hasithperera/Tensegrity-casuals-docs/README.md

# Tensegrity-casuals-docs

Documentation for the Clemson Tensegrity challenge team **Casuals**

## How to setup

1. Install [Obsidian-md](https://obsidian.md/) or any other editor program you prefer
	- obsidian is cross platform and is the preferred way to contribute to these docs
2. Clone the git repository: `git clone git@github.com:hasithperera/Tensegrity-casuals-docs.git`
3. To get write access to the repo contact the admin and you need to add an ssh key to your account - I can help with these (please ask next meeting)
4. Modify and commit your changes as needed
	- Be as descriptive as possible to make others understand the impact

## Basics

- Keep all binary files inside `res`
- Use basic Markdown and LaTeX syntax as needed
- Open the `source control view` for easy git actions

## To-do task list (auto-populated)

```tasks
# Only tasks that are not done, that is, which begin like this (but without the quotes):
#   '- [ ] ' or
#   '* [ ] ' or
#   '1. [ ] '
# Indented tasks are supported, but only single-line tasks.
not done
````
