hasithperera/Tensegrity-casuals-docs/models/Readme.md

# Strut model with ratchet

Designed by Justin H.

- Ratchet knob print settings:
	- Filament: PLA
	- Layer Height: 0.15 mm STRUCTURAL
	- Infill: 100%
	- Supports (Optional) : Everywhere - Organic
	- Print on flat face of turning knob side

- Strut body print settings:
	- Filament: PLA
	- Layer Height: 0.20 mm STRUCTURAL
	- Infill: 25%
	- Supports (Optional) : Everywhere - Organic 
	- Brim (Optional): 5 mm
	- Print upright on flat face of one end

## Current design outputs

## Ratchet

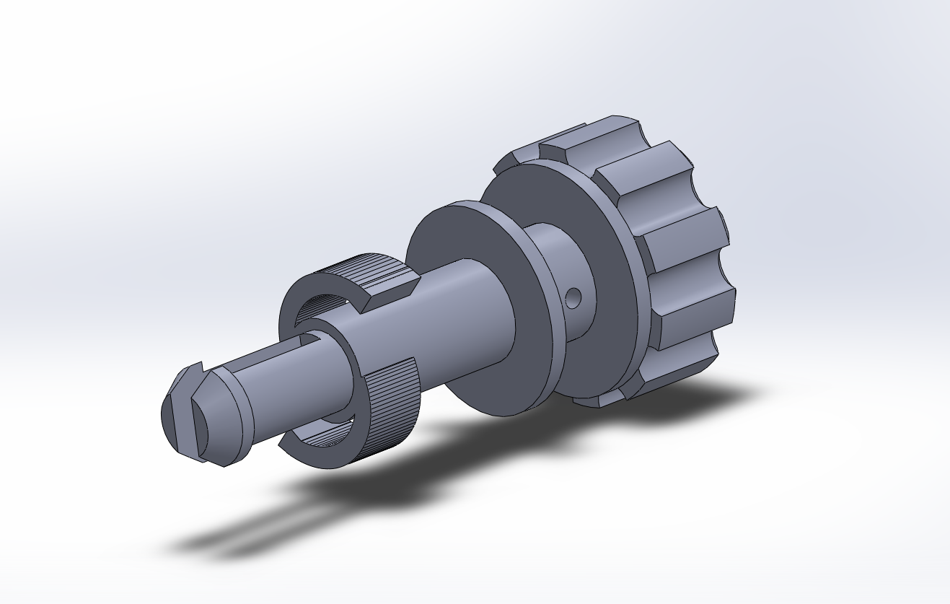
[picture p1: models/res/Ratchet Knob CAD.png]


## Strut body

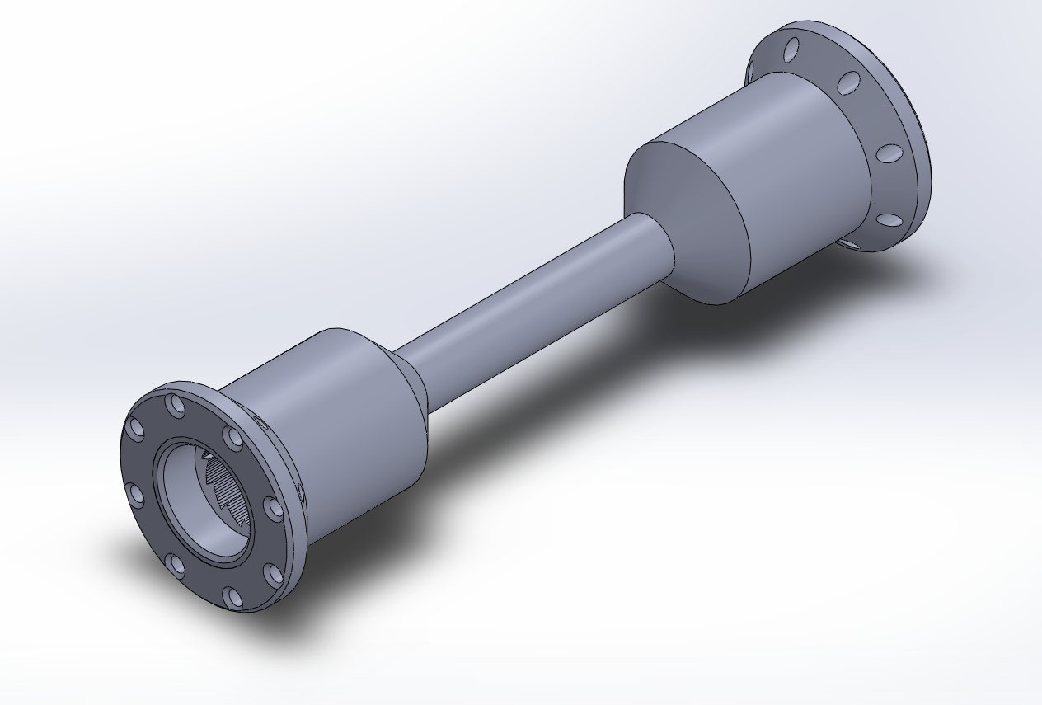
[picture p2: models/res/Strut Body CAD.png]


---
## v2 - Changes

- Some design changes that Hasith proposed to fix some of the containment issues in the current design
	- Add a locking plate to hold everything in place in the unlocked state
	- change the end to make it less flexible
	- add a locking plate to the knob, add a disk to the end, make it disengage the rotation while holding the axis

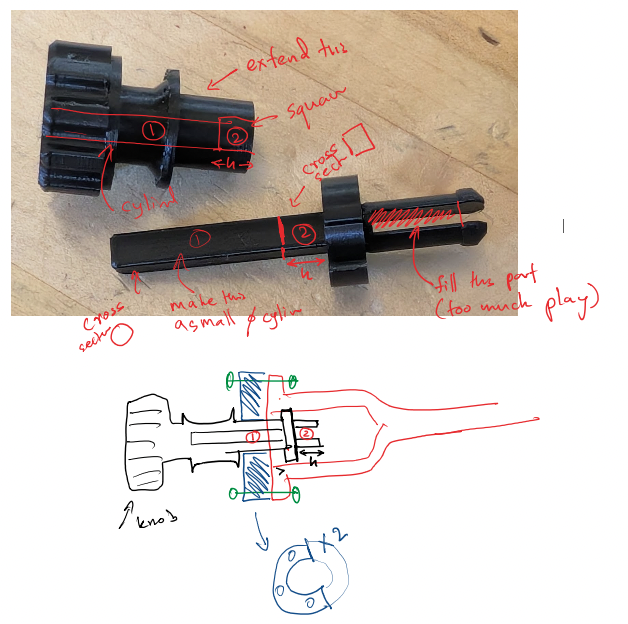
[picture p3: models/res/Pasted image 20261026123235.png]
