hasithperera/Tensegrity-casuals-docs/docs/Mechanical design and notes.md

---
marp: "true"
paginate: "True"
footer: "**Tensegrity** **Clemson University**  **Casuals**"
theme: neobeam-neonbeam
---

##  Status - 12 Nov

- David and I tested the fits; the cheaper motor I substituted with has a different clearance for the 6-pin connector (probably why it was cheap, oh well ) 
    - We did some destructive mods for the motor holder and it can be modified to fit the current motors we have. (it should probably be fine)
    - Refer to pictures below for needed modifications

## Other thoughts
- Please throw all the unwanted old case/PCB holders
	- do we actually have usable parts printed
- Figure out PCB mounting and take notes

---
## Modifications needed - David FYI

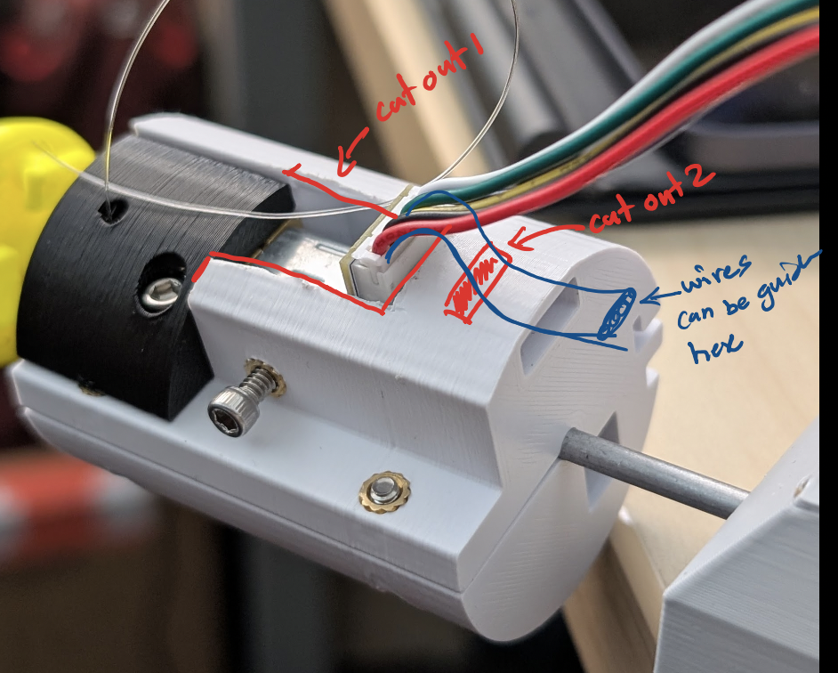
[picture p9: docs/res/Pasted image 20261112125232.png]
center


---
## Modification
- David's design was off, dimensions were not correct. Hasith redid it for quick verification
- Need to print and test for clearance, Design shown below

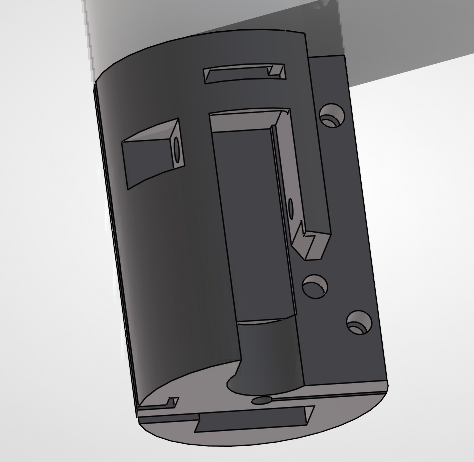
[picture p10: docs/res/Pasted image 20261113000306.png]


---

## Todo
- [ ] Redesign Motor holder #David 
	- [ ] Print PLA test design by 📅 2026-11-13  #Hasith 
- [ ] Figure out the PCB mounting
- [ ] end cap has issues; either redesign or use glue etc
