hasithperera/Tensegrity-casuals-docs/docs/PCB Design.md

# Yale design files

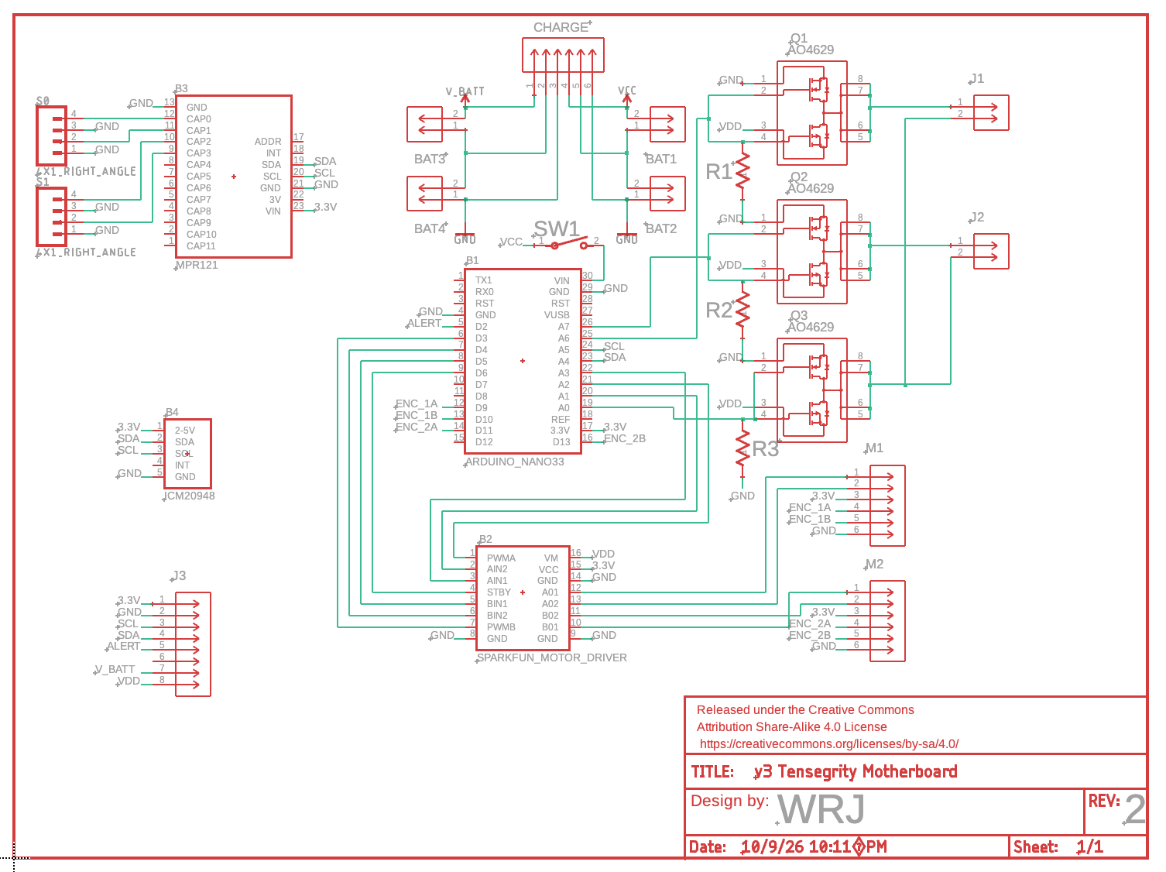
[picture p11: docs/res/Pasted image 20261009222900.png]


---
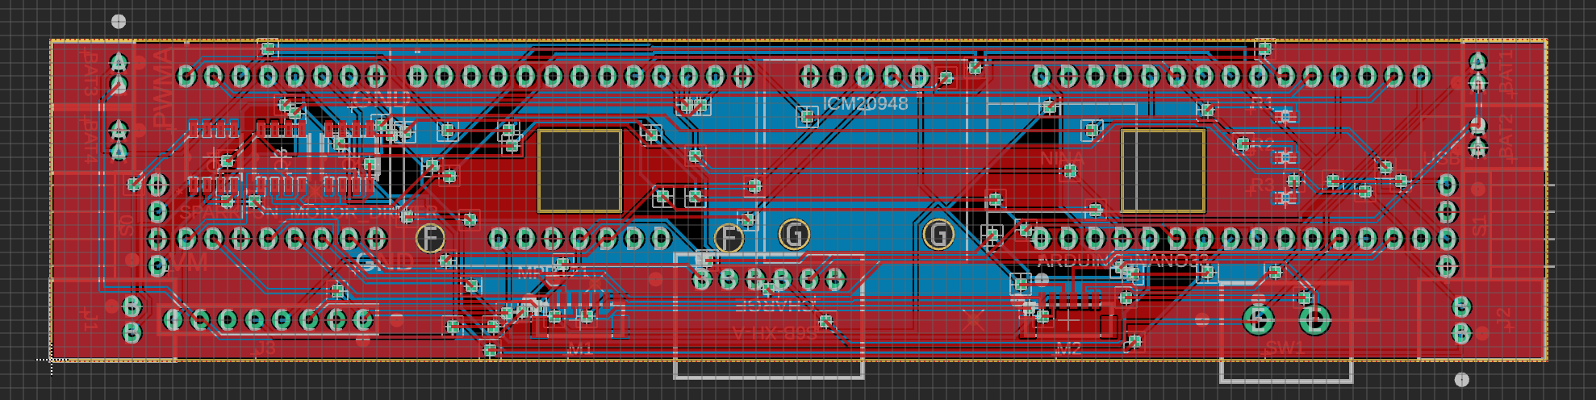
[picture p12: docs/res/Pasted image 20261009223906.png]


---
# Notes:
- There are 4 single cells: Bat 1 - 4, and these are connected to 2 x 2S cells
- Q1-3 :  AO4620
	- Dual MOSFETs, but what are these for? They are not for charging 
	- J1 J2: these are labeled as electromagnets. drive high current but what for ?
		- I don't think this is needed for this project
- Paper: https://ieeexplore.ieee.org/abstract/document/11474858
- VDD and V_Bat are connected through the [current sense module](https://mm.digikey.com/Volume0/opasdata/d220001/medias/docus/8891/4226-Datasheet.pdf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)
	- This is why they are shorted if no module is used

---
## BOM per node:
- Nano 33 IOT
- Motor driver
- Current sensor
- Connectors
---
