hasithperera/Tensegrity-casuals-docs/docs/Team logistics - Project management.md

## Task list and timeline

- [x] Document the model - pull some dimensions #David 📅 2026-10-16 ✅ 2026-10-15
	- 50-70% 
- [x] Make a scale-down mock model 📅 #Justin ⏳ 2026-10-16 ✅ 2026-10-15
- [x] Look into the PCB - remake it #Hasith 📅 2026-10-16 ✅ 2026-10-19
	- [x] Completed the PCB review ✅ 2026-10-09
	- [x] KiCad redesign 📅 2026-10-12 ✅ 2026-10-16
- [x] BOM - translation to our case (ASAP) ✅ 2026-10-19
	- Mechanical #David #Jaylin
	- Electronics #Hasith 
- [x] Schedule a meeting with Lu: #Hasith ✅ 2026-10-15
	- [x] Thursday afternoon - email her about a meeting ✅ 2026-10-19
	- [x] Talk about the high-level plan ✅ 2026-10-09
	- [x] Controller design - external controller ✅ 2026-10-09
---
# PCB dimensions from Yale

bg right contain

- This is the Yale control board; the COTS board has everything you need and more, but the physical dimensions are not feasible
- We are leaning toward a custom PCB order with a minimum design
	- Remove force feedback, but maintain the form factor
	- Add the current module 
---
# Sensor and data availability: single node 

- Each node will have
	- 9 DOF from the IMU
	- 2 Motor rotation counts 
	- 2 Current sensor data
- Inputs
	- Motor rotation with counts 
- Data via MQTT - basically the same as a ROS msg without the complications of ROS
---
# Program design 

- Each node will run the same basic firmware - sensor interface and motor drive
	- Send data via MQTT
	- High-speed sensor out via wifi (on request)
- Run the control algorithms on a Raspi/Laptop on the same network
- ROS is a possibility
	- I have done some basics about 10 years ago - on a Raspi
	- This feels like a complication at this stage since I am the only one who does software
---
# Questions

- Can we do an external controller? It's not a self-supported robot - **IS THIS OK ?**
	- I think this would be more fun for me to do
- What is the timeline for funding and fabrication?  - **Custom PCB's take time**
- I am concerned about the force feedback not being there 
	- Counts can only give you perceived inputs and not actually what's going on in the real system
	- This can go very wrong just because of the DOF on the system
- What's the use of the IMU?
	- obviously orientation, but that's kind of complicated
	- I think Yale folks had a forward model and a state estimator running in the background to predict the moves
- Electromagnet?
---
## SMILE design

- Probably more feasible 
- Paper from her website: https://smile-robotics-lab.github.io/assets/documents/papers/Tensegrity-Blocks.pdf
- Carbon rods ?
	- Looks like they are bending when the forces are applied
- Do you know the cost for this
	- 8 corners, X 2 motors each 
		- 16 motors, only 12 edges - so some motors are not needed
		- encorders? yes
		- Force feedback? probably no
---



---

# Meeting with Luyang

- Force feedback is not needed, apparently; it never worked, it seems
- External controller is fine if we do Yale
- Yale design: I think it's the fun way to do it (controller-wise)
- She showed the central controller design 
	- This has carbon fiber and springs already to take that fall as opposed to Yale will have to do it on the run time
	- From a comp point of view: central + bar design is the way to meet their criteria 
		- Yale is easy for all of us: no redesign, we just follow the things they have done and just redo it, nothing new
---

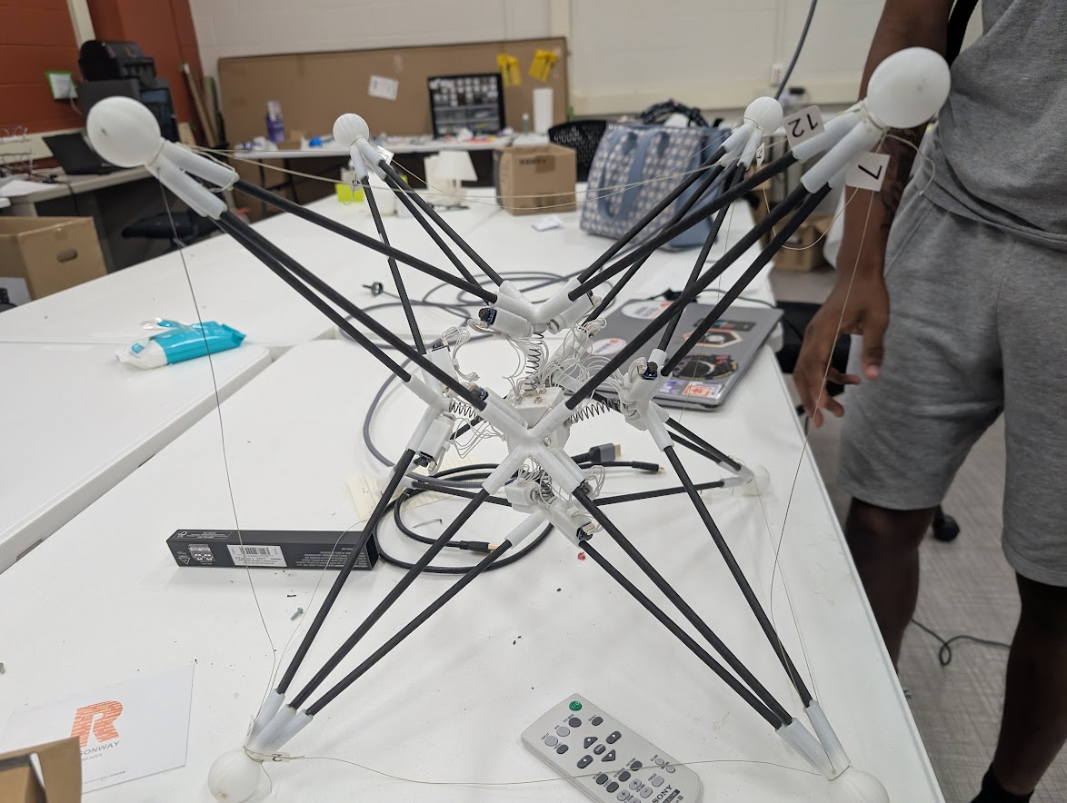
[picture p21: docs/res/Pasted image 20261015161732.png]


---

## Hasith's proposal 

- We do both; ask for more money for the 12-motor design 
	- Needs a design + BOM
	- We try Yale; if it fails, then we still have the components to do the other design
		- Mechanical design needs to be done 
		- Electronics need to be figured out to control 12 motors (this is also probably not easy to fit in that structure)
	- https://www.youtube.com/watch?v=YznAy63wcdw : Possible control system and gate
		- there are apparently a lot of implementations out there
---
## BOM and Proposal here

---
# Agenda - Team meeting 3

## Meeting time Friday 6 - 8 PM

- Talked about the new rule update and what we thing about it as a group
- Agreed to continue the project 
	- explained the replacement and corners we can cut if the budget is important to us
	- Current BOM is the reduced BOM
---
-  Mostly sharing what we learn from tomorrow's meeting, and if they question the cost or whatever, that would go in there
- [ ] Get you all setup with Obsidian and git (get you used to that) #Hasith 
- Programming basics
- Because we have 3 struts, we can write code for it simultaneously. (I am sure I can get it done by myself but getting you guys some skills may help in case I get busy) 
	- [ ] Try to write code with AI ? (I don't like this or do this but you all can try it and see which version does better) 
---
# todo - Mechanical 
- [ ] Justin: tell us how's the progress on the 3D printing #Justin 
	- [x] Model with ratchet: can you send me the files (or put them in git, with a README) ✅ 2026-10-26
	- [ ] Endcap: can we redesign this to print with the resin printer (for some deformable rubber-like material)
- [ ] ROS - can someone learn about this and find a tutorial to follow #name
---
## Meeting 4 - 29/10

- [ ] Printing progress #Justin 
	- Changes in the PCB holder and PCB cover
	- Justin
		- 3 done already. 
		- Needs the bottom PCB holder reprint
	- [ ] TPU endcaps #David 
		- Ask Luyang 
- [ ] Mechanical Assembly all done by 📅 2026-11-05 #David #Jaylin #Justin 
	- [ ] fishing line and knots #David 
	- It will take more time than you think - took me 3 hs to put that thing together 
	- leave the electronics for me, you can install the motors, leave the PCB out, wire the battery too
		- find space-time
	- make all struts
	- I encourage every one to participate.
		- either learn a new skill
		- or just put time to do some thing you know
---

- [ ] Programming 
	- AI work flow ? I want to try this for this project
	- so called agents - I don't think it will work too well but who knows maybe it will be faster
- [ ]  Item pickup and tracking
	- [x] need some one to do this, email Luyang/TA basically to get them, check the items off in, and verify the content with what we ordered - not too hard ✅ 2026-10-29
	- [ ] Email to Cath - Justin ? (or talk to her) #Justin 
- [ ] Start thinking about the report
	- put down a doc
----
### Next checkin logistics
- Please take notes, and also take notes on other groups progress
	- I will try to be on zoom/teams if they do it as a online meeting
- ask about Luyang's lab access - I emailed nothing back yet
	- ask what the issue is, and how we can do it
	- there are possible alternate options (but they said they would provide it so)
- Show and tell - if you want to show the model, I think its a good to show. (its a pretty solid design and it help me understand the dynamics and also fun to play with etc)

---
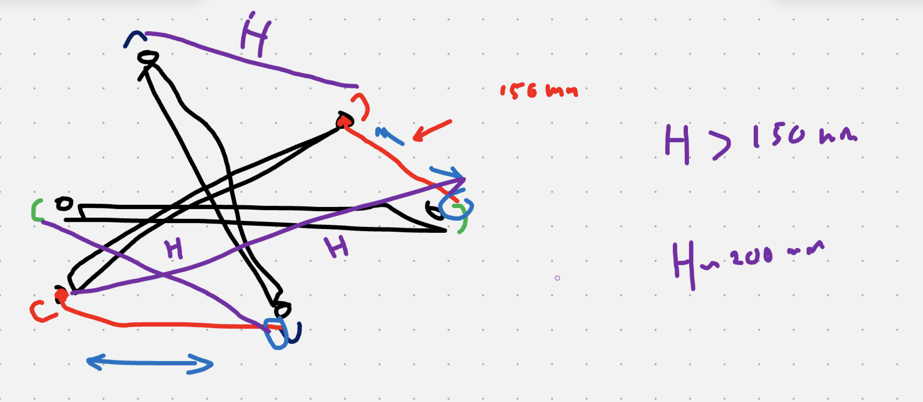
[picture p22: docs/res/Pasted image 20261029203758.png]


---

- Oppose extension of the competition to the next semester
	- Hasith: Personally joined since it was strictly stated as a 12 Week program, hard no to extension. Unavailable after Dec 10 travel
		- force then to get a date now
		- Fall schedule link: https://www.clemson.edu/registrar/academic-resources/calendar.html?year=2027&semester=second-fall
			- Dec 6 : Last day of classes
			- Dec 7: Study day
			- I am fine with doing it on a weekend if needed
			- Exam week - No due to others probably (I am actually fine with it)
---
