hasithperera/Tensegrity-casuals-docs/docs/Basic challenge info and updates.md

# Meeting 1: Interest meeting

- Slide are here
- Make your teams min 3 max 5 members
- they will have workshops
- 10-12 weeks for the whole program
- More info to come

---
# Workshop 1

- Slides here
- Shared notes real time: https://pad.education/p/casulas
	- use this to edit and take more notes every meeting
- We made a 3 person team
	- added 2 other members from the radio club
	- Meeting time link: https://www.when2meet.com/?39104438-g3Ddf
	- David made a teams chat for CAD files
- [x] BOM submission 📅 2026-10-20 ✅ 2026-10-19 #Hasith
- [x] set up a zoom link 📅 2026-10-08 ✅ 2026-10-08 #Hasith 
- [x] Order PCB email ✅ 2026-10-16 #Hasith 

---
# Workshop 2 - 20/10/2026

- Nothing too important.
- Scoring matric 
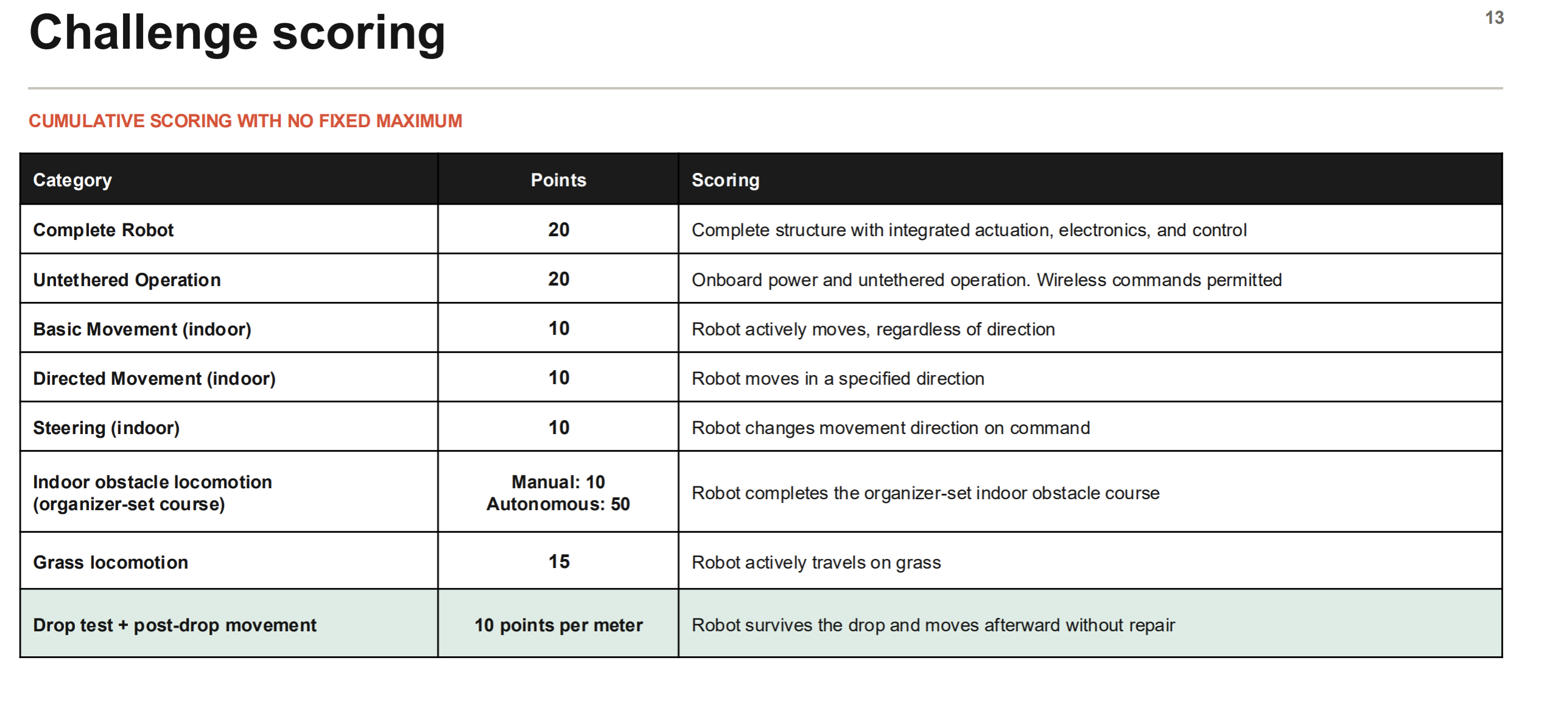
[picture p23: docs/res/Pasted image 20261021135912.png]


- Wu emails a new rubric with more constraints with penalties for going over $500.
	- This makes us rethink our current design 
	- How can we cut costs 
---
