hasithperera/Tensegrity-casuals-docs/docs/Slides - on the go.md

# SMILE  - Alternate design
- Rejected due to design timeline constraints
- Would require custom Hardware and Electronic design 

bg right contain

---
## Yale Desing

bg right contain

- This is the Yale control board; the COTS board has everything you need and more, but the physical dimensions are not feasible
- We are leaning toward a custom PCB order with a minimum design
	- Remove force feedback, but maintain the form factor
	- Add the current module 
---


---
bg contain

---


---


---

bg contain
