hasithperera/Tensegrity-casuals-docs/docs/Slides - on the go workshop 2.pdf

Team Casuals
Hasith Perera, Justin Hsu, David Niemczura, and Jaylin Washington
Tensegrity | Casuals | 1 / 12

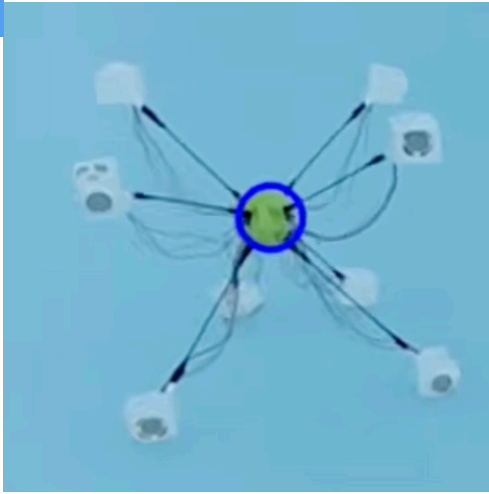
[picture p24: figure]

Rejected due to design timeline constraints

Would require custom Hardware and Electronic design

## SMILE - Alternate design

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
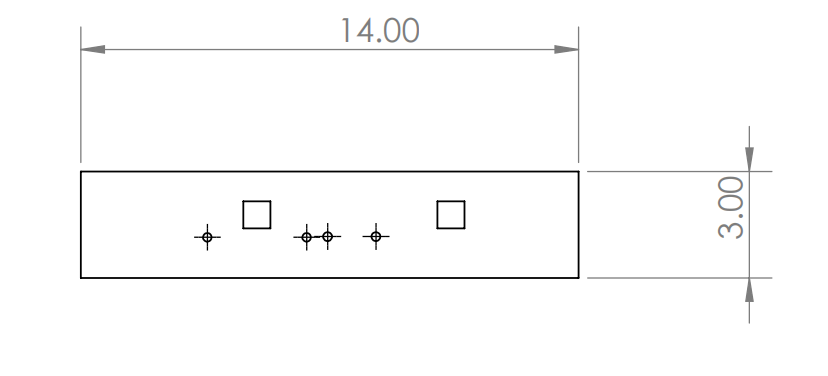
[picture p25: figure]

This is the

Yale control board; the
COTS board has everything you need and more, but the physical dimensions are not feasible We are leaning toward a custom

PCB order with a minimum design Remove force feedback, but maintain the form factor

Add the current module Tensegrity | Casuals

3

/

1

2

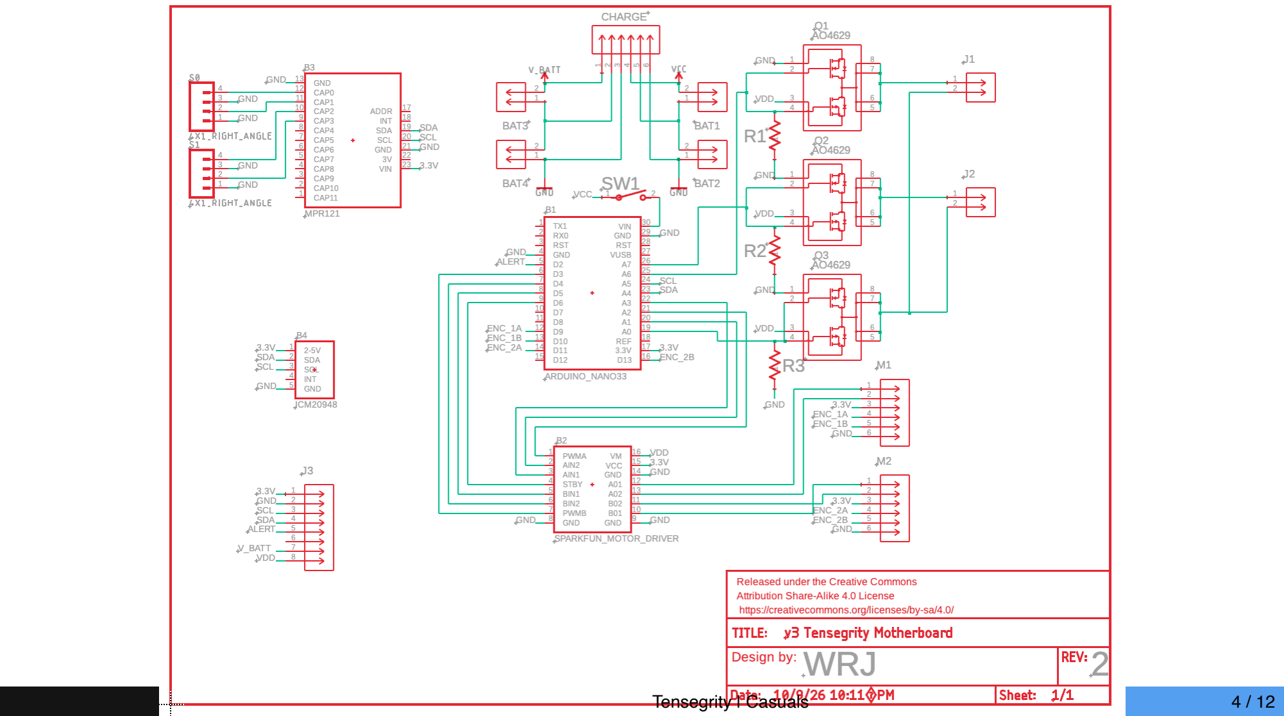
[picture p26: page 4]
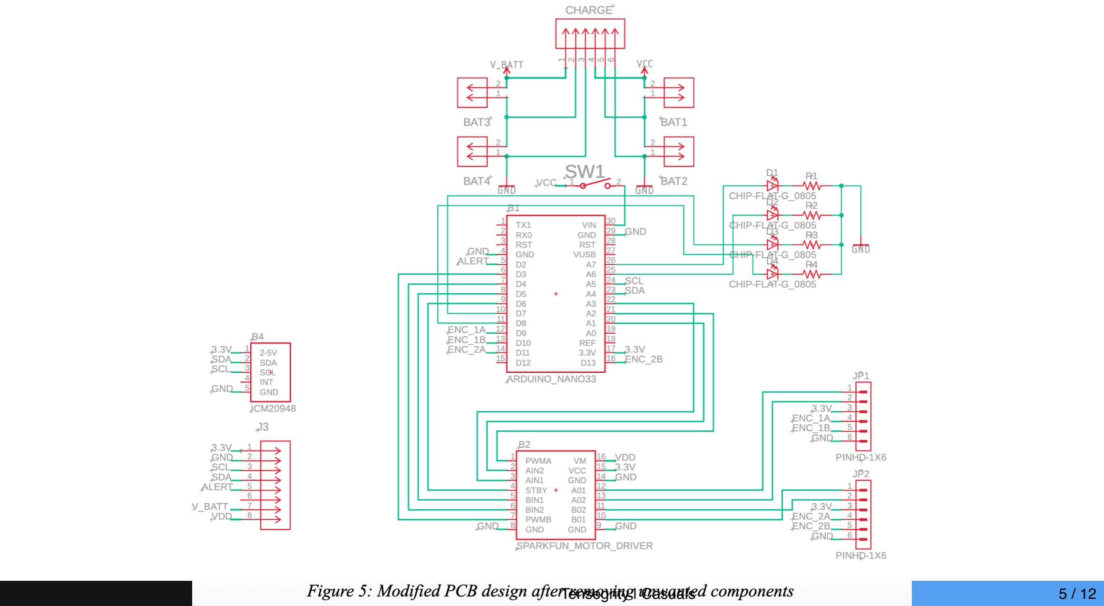
[picture p27: page 5]

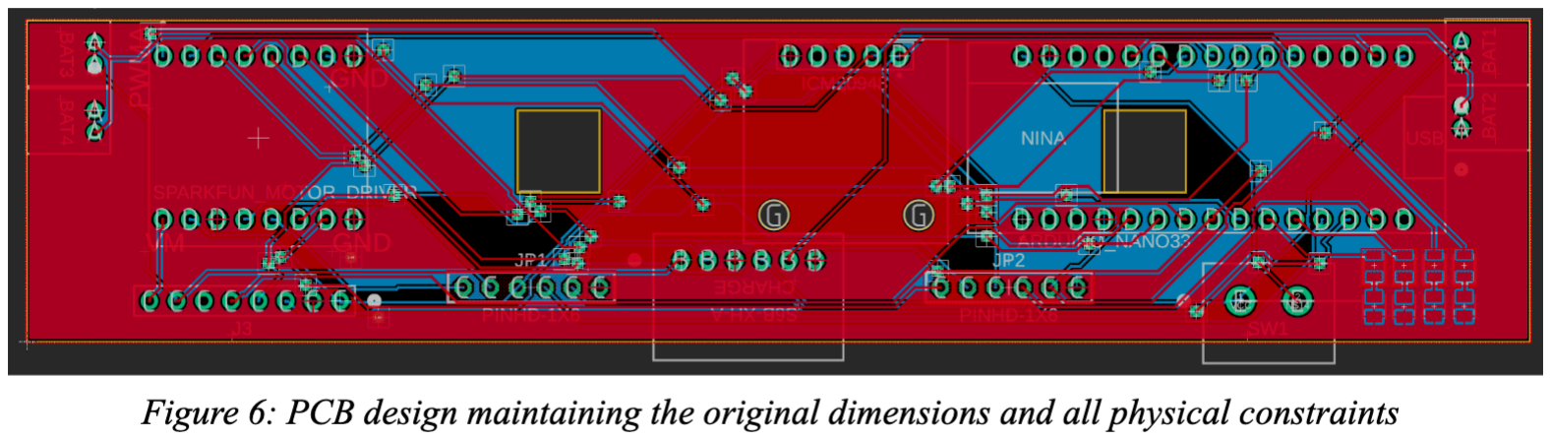
[picture p28: figure]
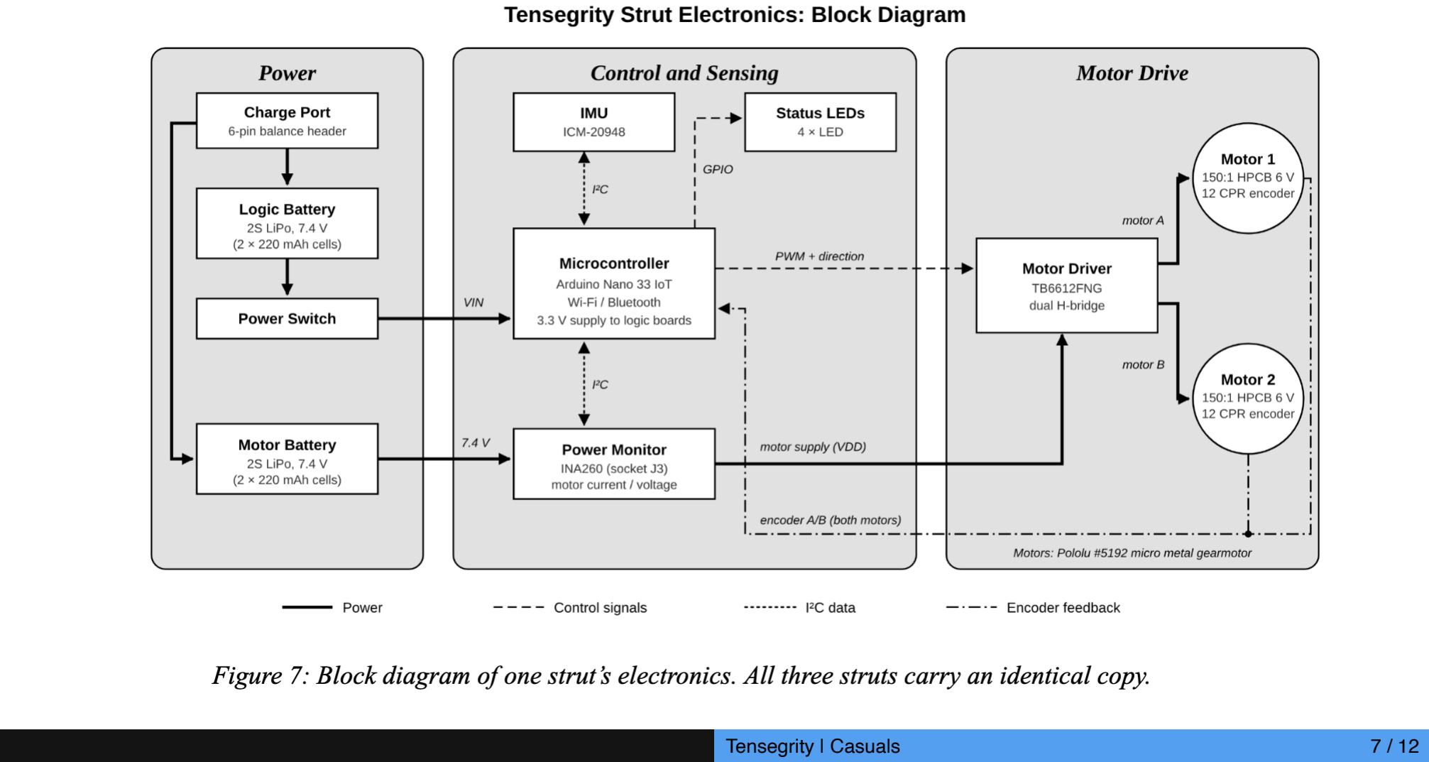
[picture p29: page 7]

## Initial proposed time line

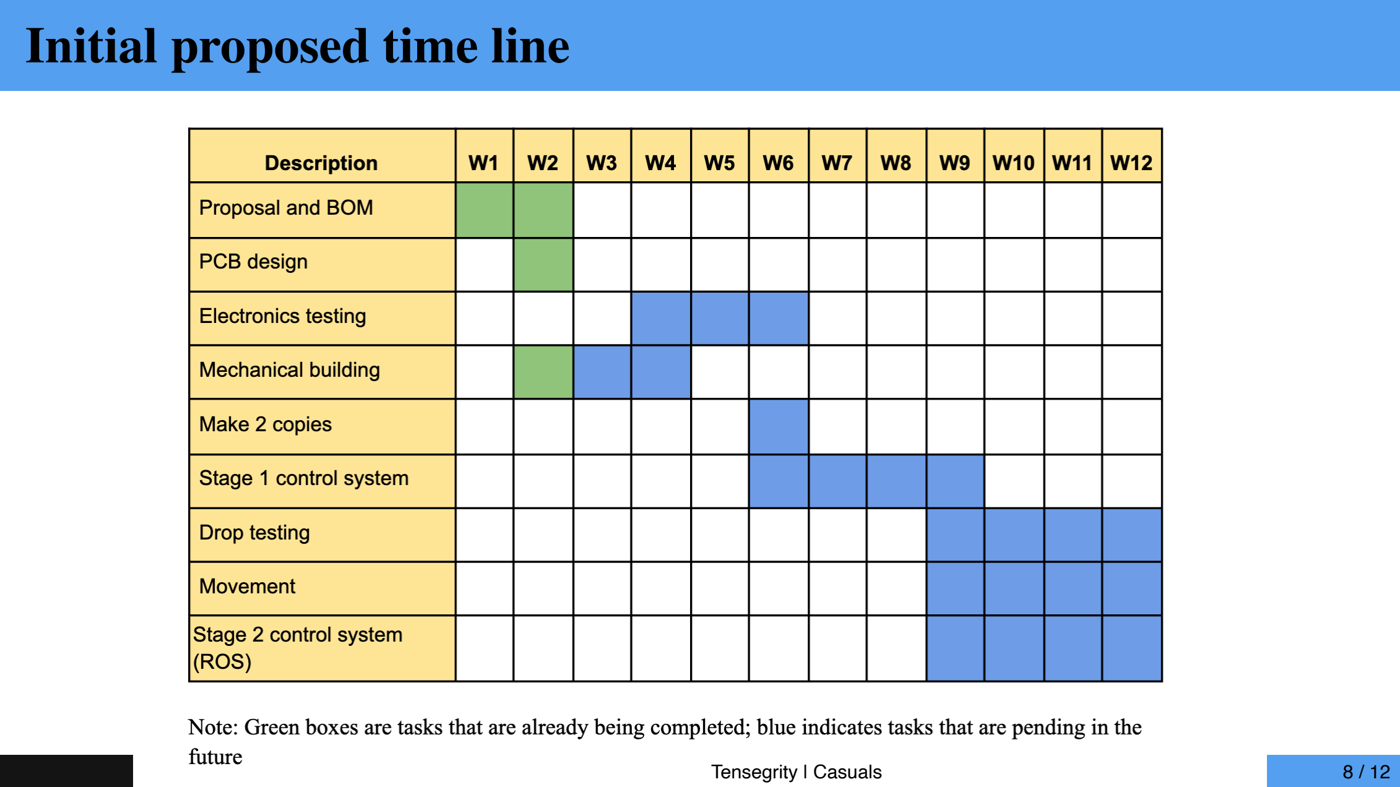
[picture p30: page 8]

Team Casuals
Hasith Perera, Justin Hsu, David Niemczura, and Jaylin Washington

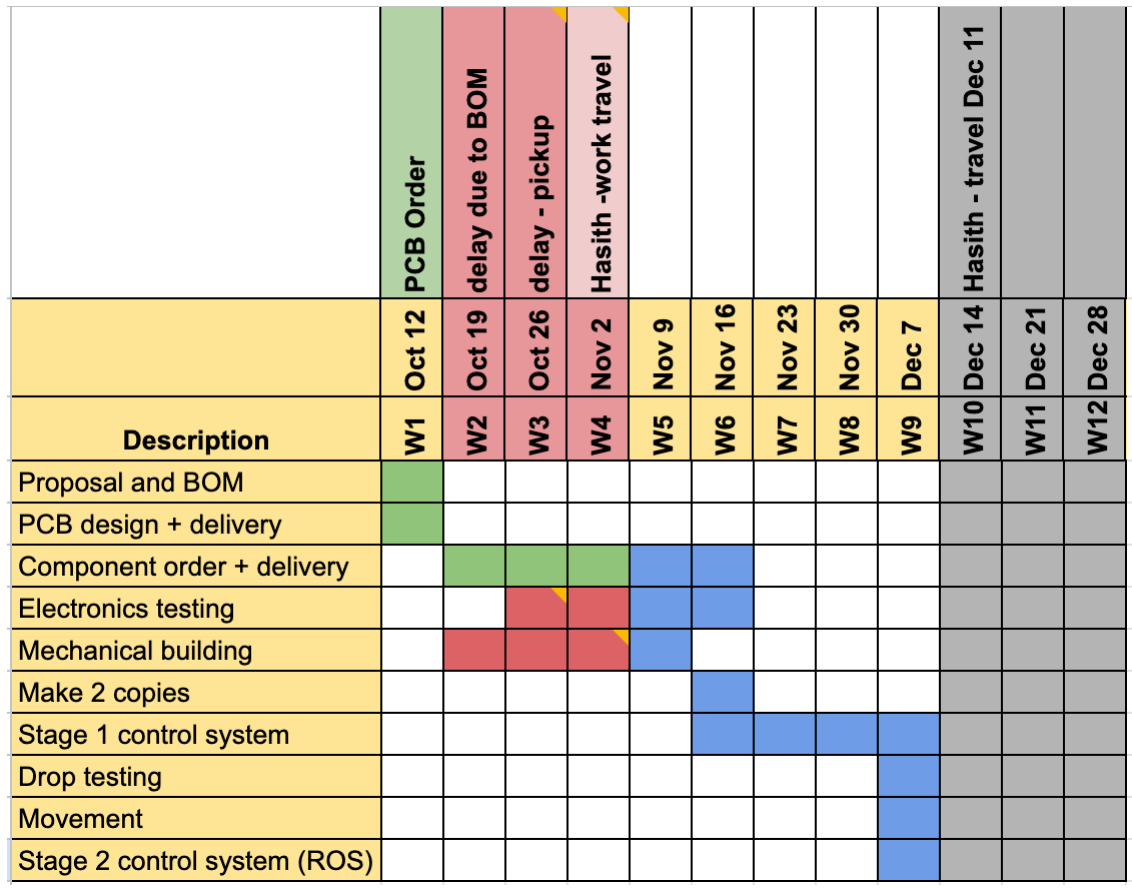
[picture p31: figure]

Additional constrains and
resubmission of the BOM added a week of delay
Item review and delivery/pickup again added ~ 1.5 weeks

Lab space/soldering access has not been provided yet

## Updated and current time line

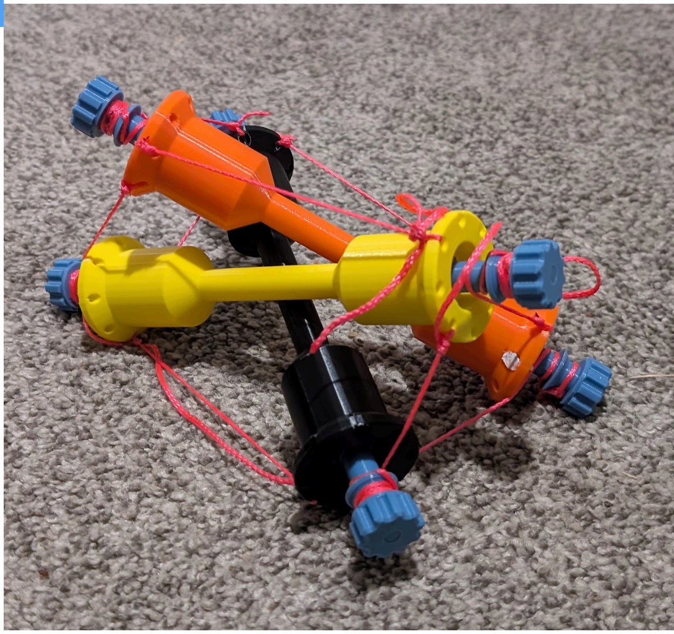
[picture p32: figure]

Justin and Hasith put together a model to see how this design will work and maintain stability
it works on a ratchet
mechanism
We found that the fixed string length is a constraint we have to tune. (This is not specified in any of the public documents)

## Progress

The controller Yale design is using is a Nano 33 IoT This is a single core

they are not using interupts in there code

using UDP packets to get data in and out of the 3 structs no close loop controllers are running in the struts
Would putting 4 encoder signals break the speed required for UDP data

Should we upgrade to a dual core processor can be done

## Current issues we are thinking about
