hasithperera/Tensegrity-casuals-docs/docs/res/Pasted image 20261014223857.png

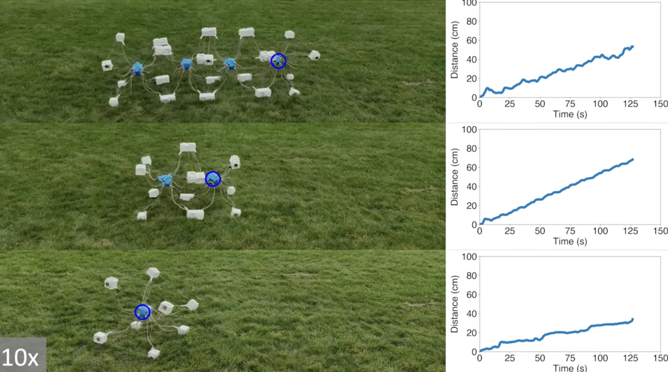
docs/res/Pasted image 20261014223857.png
