hasithperera/Tensegrity-casuals-docs/docs/res/Pasted image 20261020182320.png

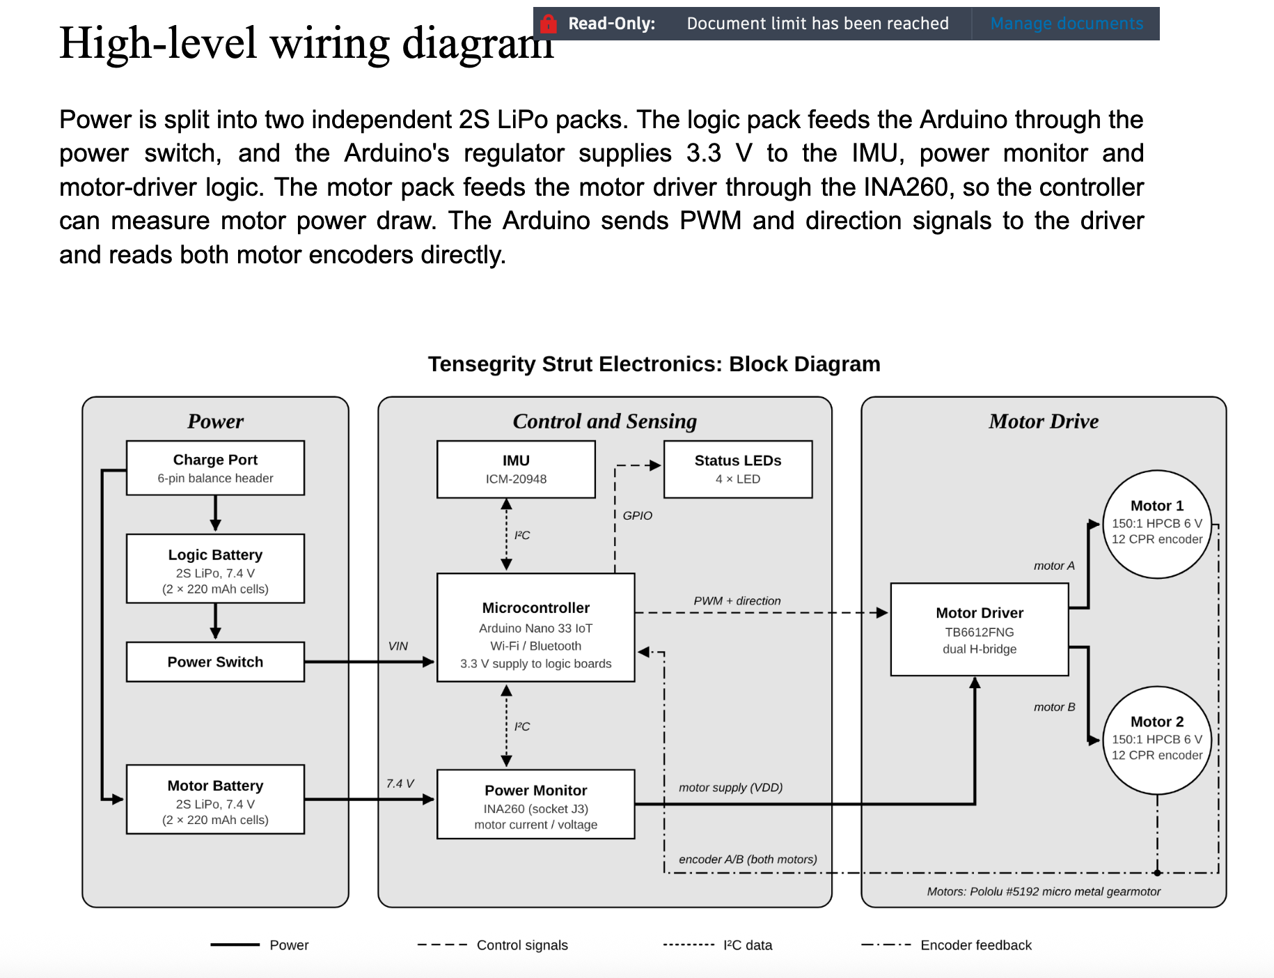
docs/res/Pasted image 20261020182320.png
