hasithperera/Tensegrity-casuals-docs/docs/res/Pasted image 20261114125745.png

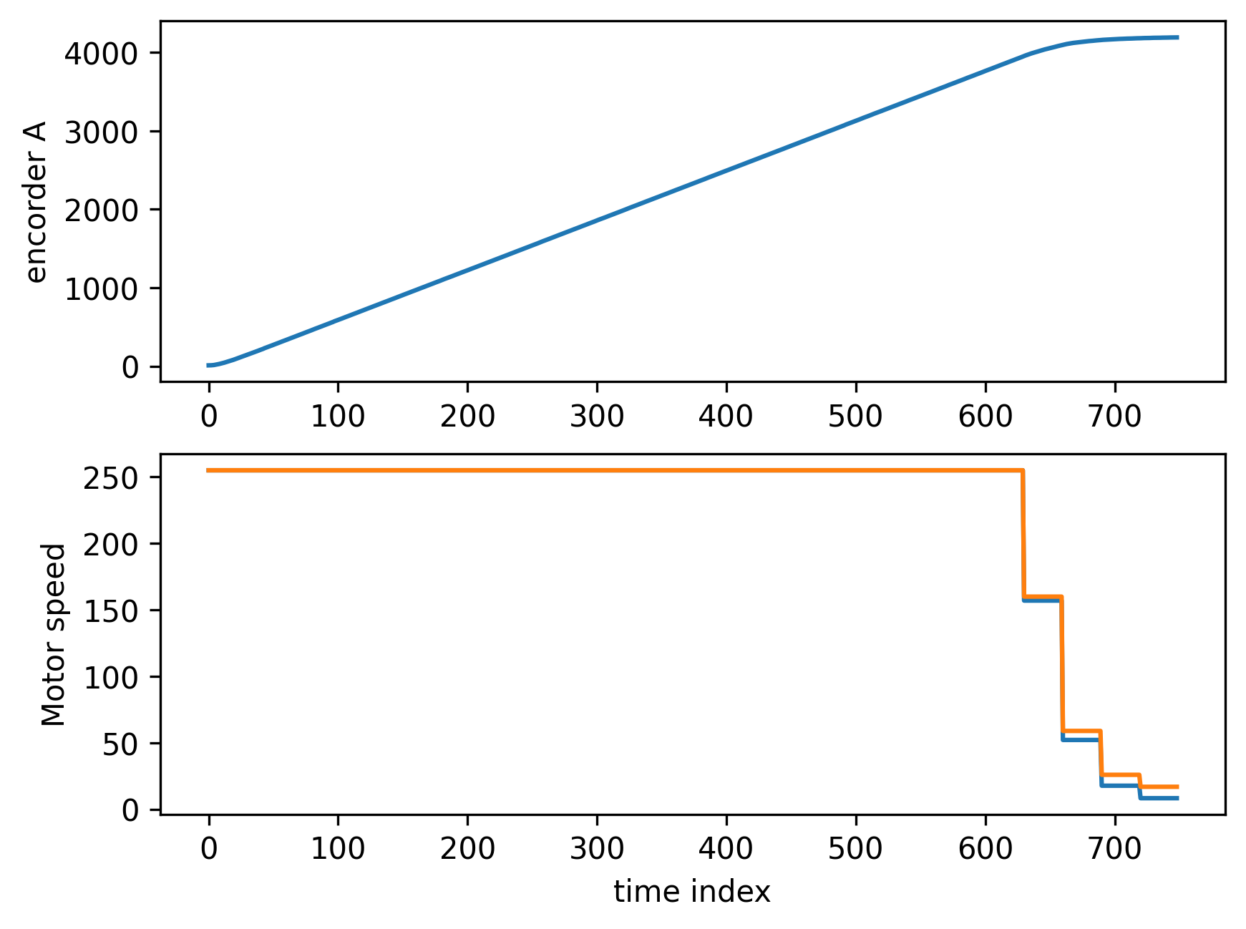
docs/res/Pasted image 20261114125745.png
