hasithperera/Tensegrity-casuals-docs/models/solidworks/Ratchet Knob Spool.SLDPRT

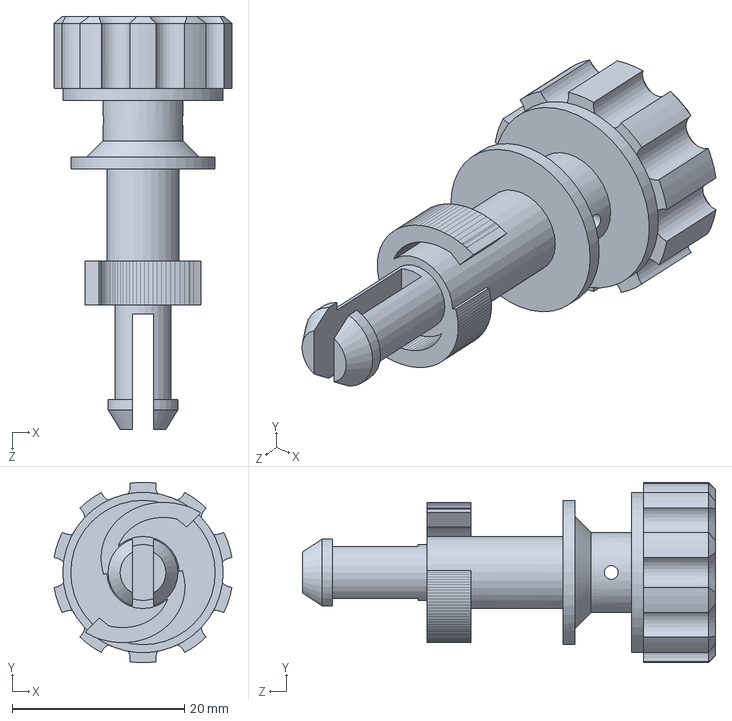
[picture p61: CAD file, 2026-10-21]
models/solidworks/Ratchet Knob Spool.SLDPRT
20.6 x 20.9 x 47.9 mm
