hasithperera/Tensegrity-casuals-docs/models/solidworks/One Piece Strut Body.SLDPRT

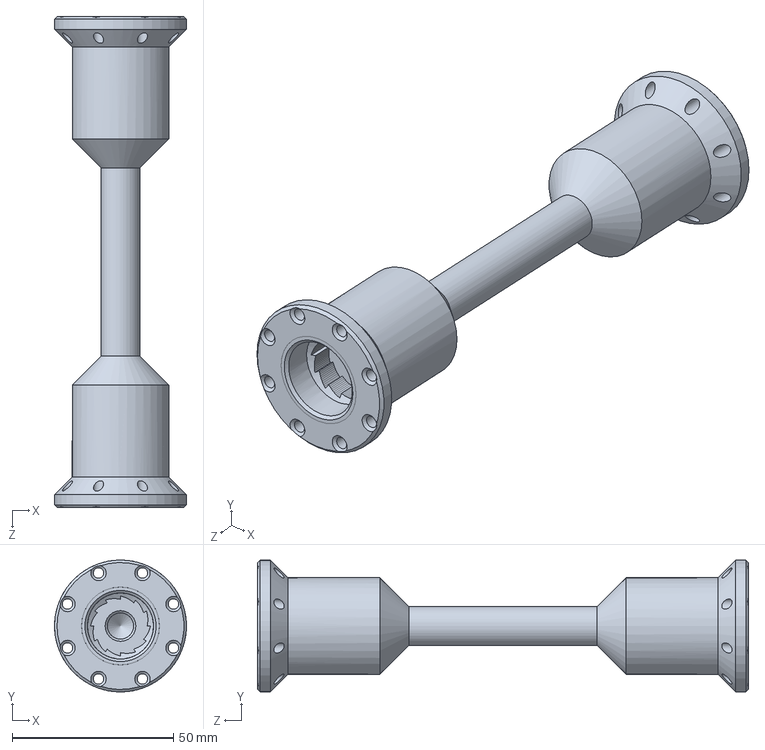
[picture p62: CAD file, 2026-10-21]
models/solidworks/One Piece Strut Body.SLDPRT
41.0 x 41.0 x 152.4 mm
