hasithperera/Tensegrity-casuals-docs/(list of files, cad)

Other CAD files:
Ratchet Knob Spool.STL
models/One Piece Strut Body.STL
