hasithperera/Tensegrity-casuals-docs/pcb/main-controller/main-controller.kicad_sch

## KiCad design pcb/main-controller/main-controller.kicad_sch (2026-10-16)

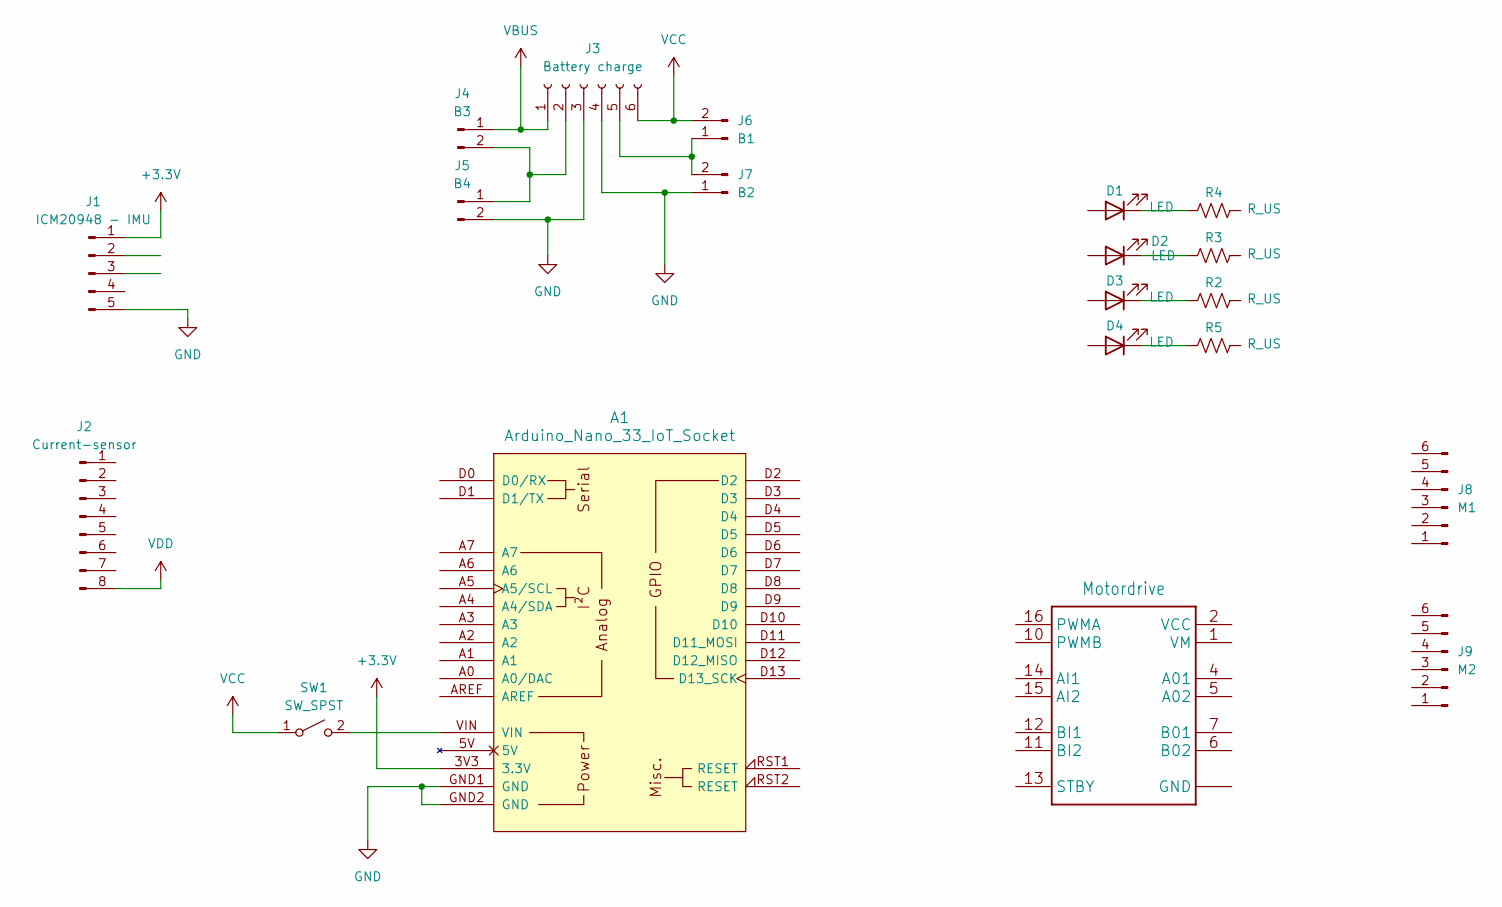
[picture p63: schematic main-controller.kicad_sch]

Parts:
A1: Arduino_Nano_33_IoT_Socket
D1, D2, D3, D4: LED
J1: ICM20948 - IMU
J2: Current-sensor
J3: Battery charge
J4: B3
J5: B4
J6: B1
J7: B2
J8: M1
J9: M2
Motordrive: MODULE_ROB-14450
R2, R3, R4, R5: R_US
SW1: SW_SPST

Connections:
+3.3V: A1.3V3 (3.3V), J1.1
GND: A1.GND1 (GND), A1.GND2 (GND), J1.5, J3.3, J3.4, J5.2, J7.1
unnamed: A1.VIN, SW1.2 (B)
unnamed: D1.1 (K), R4.1
unnamed: D2.1 (K), R3.1
unnamed: D3.1 (K), R2.1
unnamed: D4.1 (K), R5.1
unnamed: J3.2, J4.2, J5.1
unnamed: J3.5, J6.1, J7.2
unnamed: Motordrive.3 (GND), Motordrive.8 (GND), Motordrive.9 (GND)
VBUS: J3.1, J4.1
VCC: J3.6, J6.2, SW1.1 (A)
VDD: J2.8
