hasithperera/Tensegrity-casuals-docs/(commit log)

2026-10-10 added the schematic basics
2026-10-20 added the BOM PDF
2026-10-21 #2 moved the cad models to a folder and added readme files
2026-10-25 Update Readme with print settings for models
    Added detailed print settings for ratchet knob and strut body.
2026-11-02 removed Solidwork filed and added the step file for the board
